milaa007/Anagoluus-Line-following-robot-no-microcontroller-/Circuit Design.png

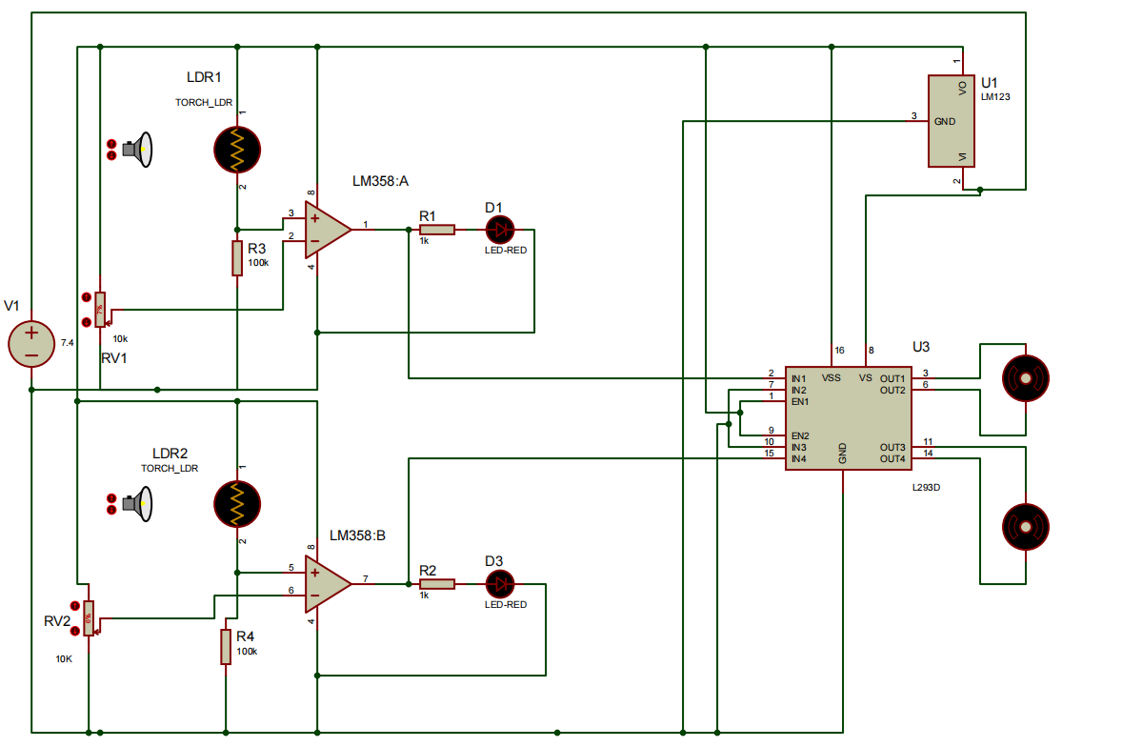
Circuit Design.png
