milaa007/Anagoluus-Line-following-robot-no-microcontroller-/(list of files, drawings)

Other design files:
Linefolloweranagolous.pdsprj
